qwertpas/O12encoder/v2/O12encoder.step

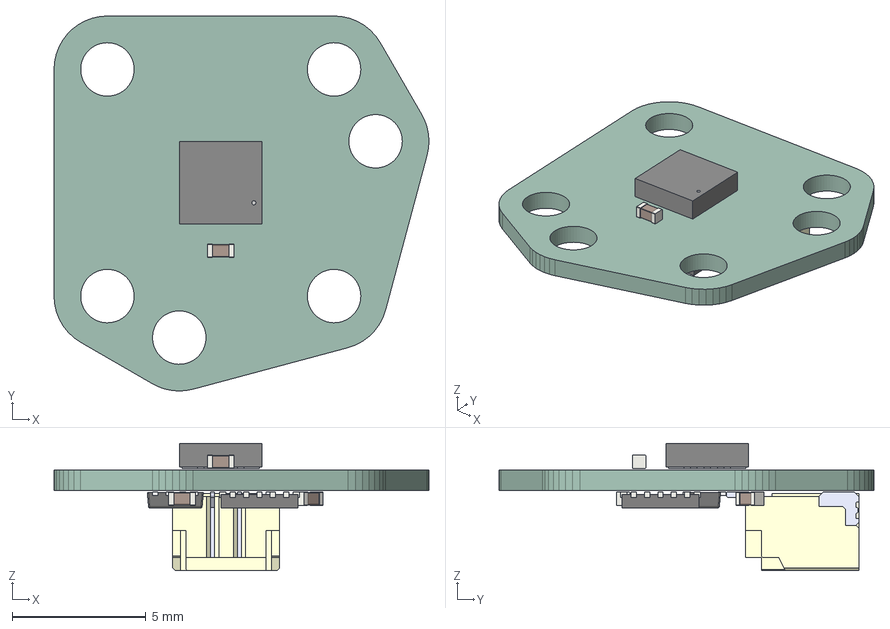
[picture p4: CAD file, 2024-03-10]
v2/O12encoder.step
14.0 x 14.0 x 4.77 mm
_autosave-O12encoder PCB
