qwertpas/O12encoder/v2/encoder_outline.dxf

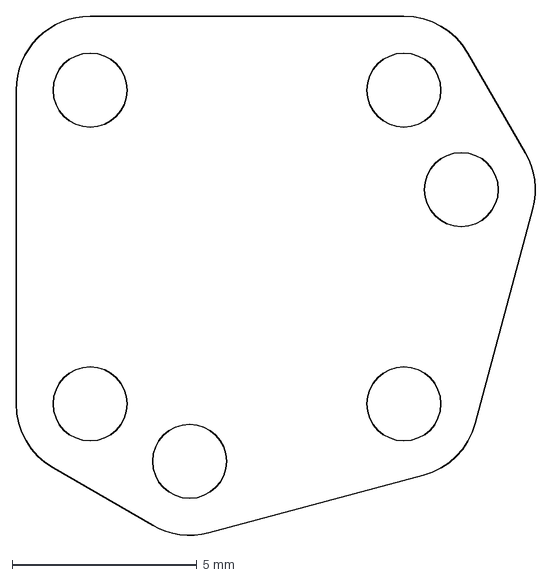
[picture p5: CAD file, 2024-03-10]
v2/encoder_outline.dxf
14.1 x 14.1 mm
