qwertpas/O12encoder/v2/O12encoder.pdf

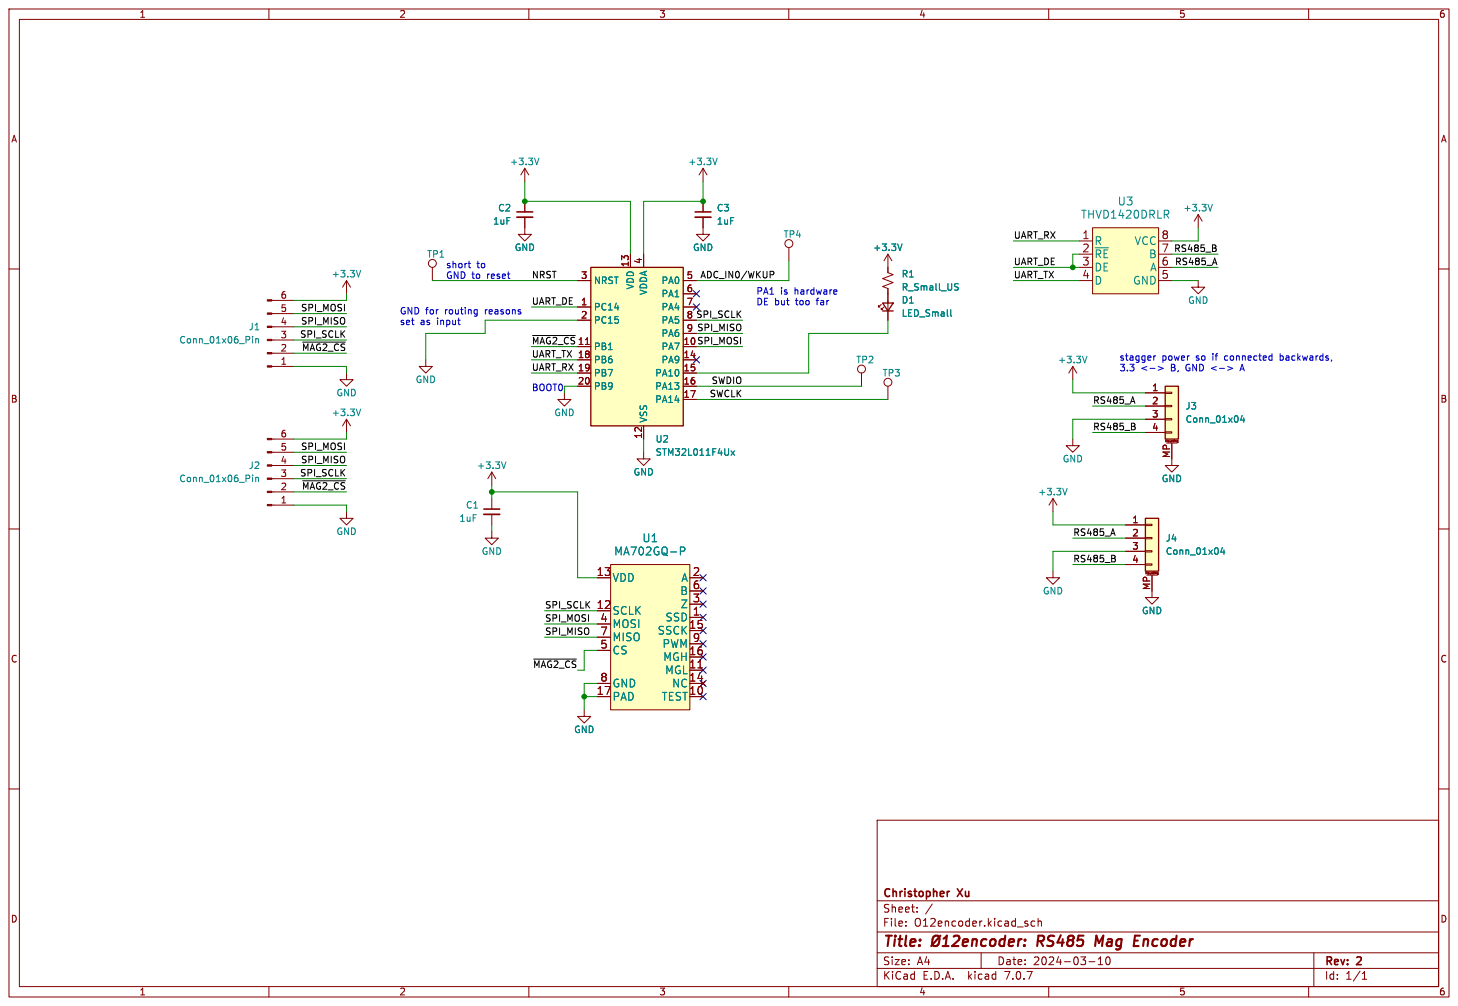
[picture p6: page 1]
