qwertpas/O12encoder/v1/O12encoder.pdf

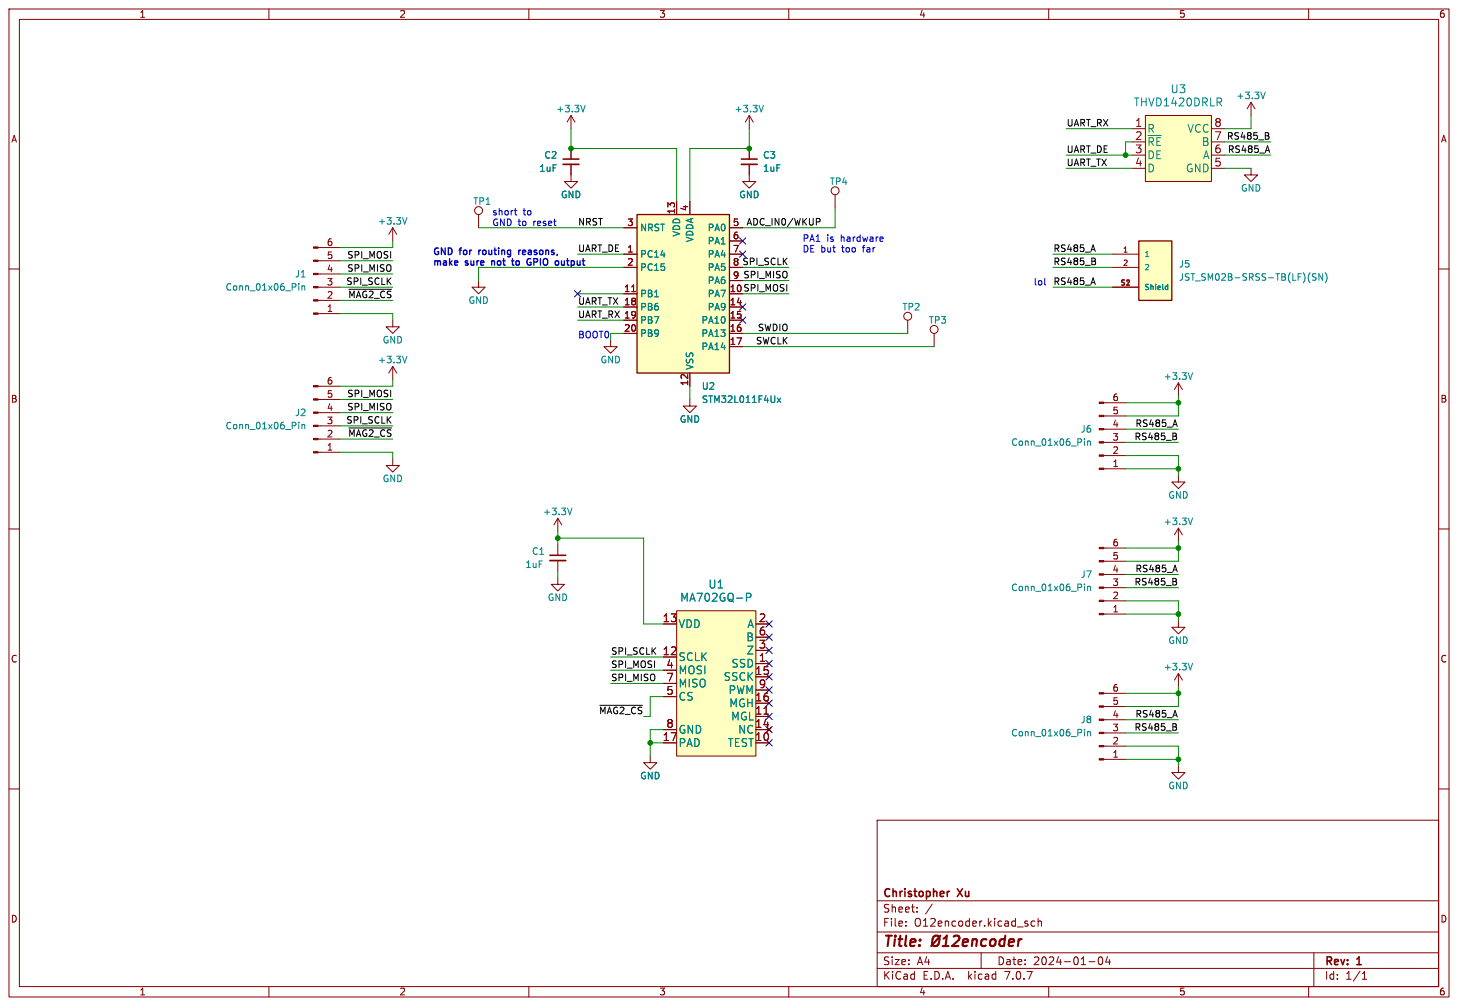
[picture p7: page 1]

JST_SM02B-SRSS-TB(LF)(SN) C1

Id: 1/1 Title: þÿØ12encoder File: O12encoder.kicad_sch Sheet: / Christopher Xu
