qwertpas/O12encoder/v2/O12encoder.kicad_pcb

## KiCad design v2/O12encoder.kicad_pcb (2024-03-11)

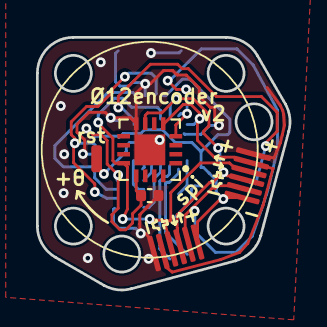
[picture p8: board O12encoder.kicad_pcb from above]

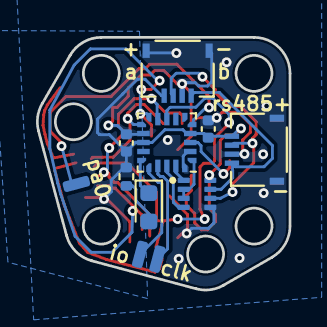
[picture p9: board O12encoder.kicad_pcb from below]

Board: 2 copper layers, 14.0 x 14.0 mm, 16 parts (11 on the bottom side), 17 nets.

Parts:
C1, C2, C3: 1uF; C_0402_1005Metric
D1: LED_Small; LED_0603_1608Metric
J1, J2: Conn_01x06_Pin; FFC_0.5mm_6p
J3, J4: Conn_01x04; TE_2328702-4
R1: R_Small_US; R_0402_1005Metric
TP1, TP2, TP3, TP4: TestPoint; TestPoint_Pad_Rect
U1: MA702GQ-P
U2: STM32L011F4Ux; ST_UFQFPN-20_3x3mm_P0.5mm
U3: THVD1420DRLR; THVD1420DRLR_SOT-585

Connections:
+3.3V: C1.1, C2.1, C3.1, J1.6, J2.6, J3.1, J4.1, R1.1, U1.13 (VDD), U2.4 (VDDA), U2.13 (VDD), U3.8 (VCC)
/ADC_IN0/WKUP: TP4.1, U2.5 (PA0)
/NRST: TP1.1, U2.3 (NRST)
/RS485_A: J3.2, J4.2, U3.6 (A)
/RS485_B: J3.4, J4.4, U3.7 (B)
/SPI_MISO: J1.4, J2.4, U1.7 (MISO), U2.9 (PA6)
/SPI_MOSI: J1.5, J2.5, U1.4 (MOSI), U2.10 (PA7)
/SPI_SCLK: J1.3, J2.3, U1.12 (SCLK), U2.8 (PA5)
/SWCLK: TP3.1, U2.17 (PA14)
/SWDIO: TP2.1, U2.16 (PA13)
/UART_DE: U2.1 (PC14), U3.2 (~RE), U3.3 (DE)
/UART_RX: U2.19 (PB7), U3.1 (R)
/UART_TX: U2.18 (PB6), U3.4 (D)
/~MAG2_CS: J1.2, J2.2, U1.5 (CS), U2.11 (PB1)
GND: C1.2, C2.2, C3.2, J1.1, J2.1, J3.3, J3.MP (MountPin), J4.3, J4.MP (MountPin), U1.8 (GND), U1.17 (PAD), U2.2 (PC15), U2.12 (VSS), U2.20 (PB9), U3.5 (GND)
unnamed: D1.2 (A), R1.2
unnamed: D1.1 (K), U2.15 (PA10)
